agmlego/air-compressor-controller/Production/compressor schematic 3.jpg

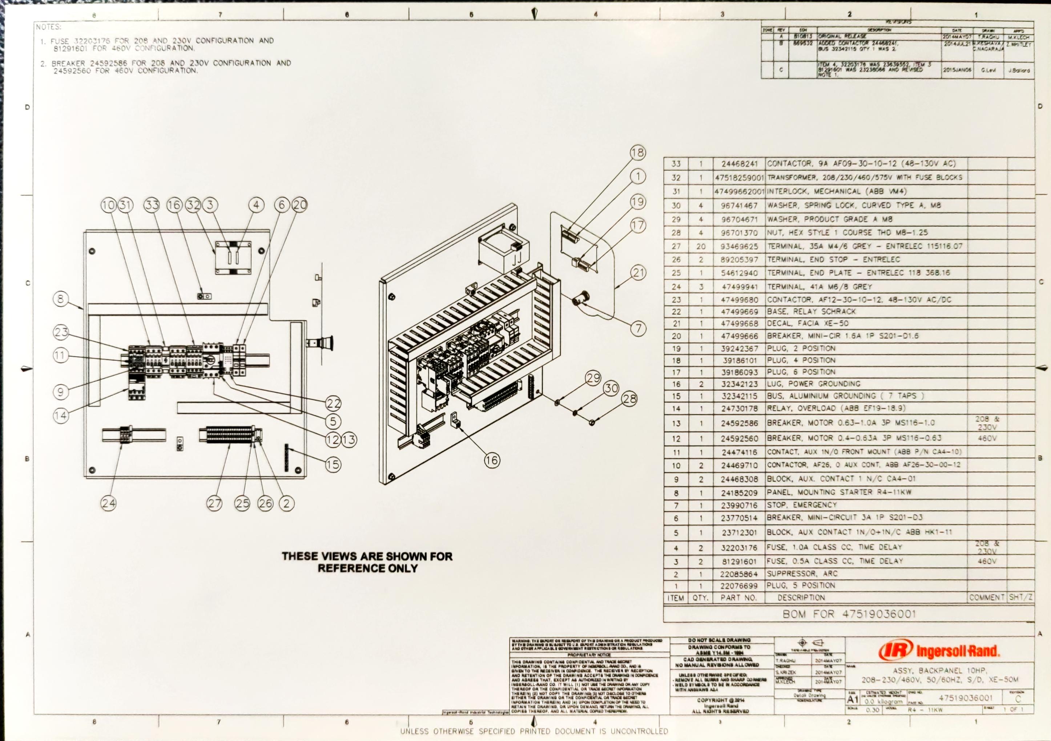
Production/compressor schematic 3.jpg
