agmlego/air-compressor-controller/Production/compressor schematic 1.jpg

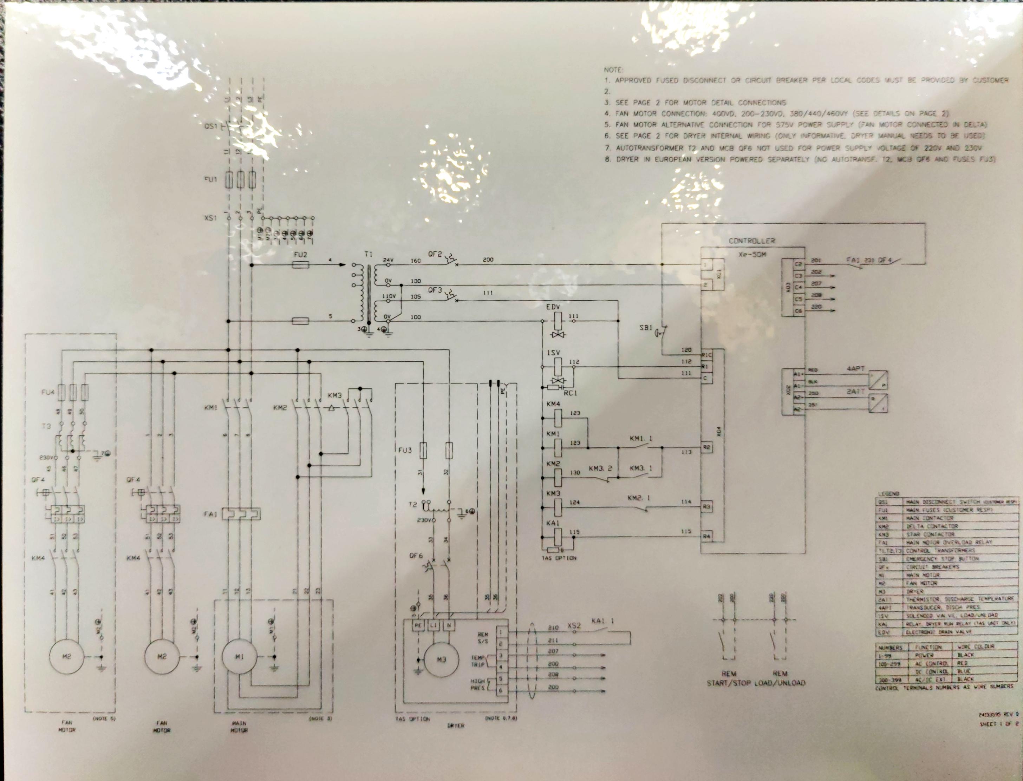
Production/compressor schematic 1.jpg
