agmlego/air-compressor-controller/Hardware/pins.xlsx

Conn ID | Connector | Pin | Signal | Terminal | PCB | Terminal | Y
J9 | Compressor controller | 8 | 0V |  | X
J9 | Compressor controller | 10 | BUS_DIR |  | X | Row Labels | Count of Signal | Terminals
J9 | Compressor controller | 6 | BUS_RX |  | X | 0V | 9 | 5
J9 | Compressor controller | 4 | BUS_TX |  | X | 24V | 5 | 3
J9 | Compressor controller | 2 | BUS_VCC |  | X | GND | 4 | 2
J1 | Power input | 2 | 0V | Y | Y | 5V | 4 | 2
J1 | Power input | 1 | 24V | Y | Y | L1 | 2 | 1
??? | 5V output | 1 | 5V | Y | Y | L2 | 2 | 1
A-PSI1 | A-side pressure sensor | 2 | A-PSI | Y | Y | RED | 1 | 1
B-PSI1 | B-side pressure sensor | 2 | B-PSI | Y | Y | OUT3 | 1 | 1
J8 | Compressor status | 2 | COMP-STATUS |  | Y | AMBER | 1 | 1
MAIN-PSI1 | Main pressure sensor | 2 | MAIN-PSI | Y | Y | A-PSI | 1 | 1
J9 | Compressor controller | 7 | OFF_BTN- |  | Y | OUT4 | 1 | 1
J9 | Compressor controller | 5 | OFF_BTN+ |  | Y | MAIN-PSI | 1 | 1
J9 | Compressor controller | 3 | ON_BTN- |  | Y | B-PSI | 1 | 1
J9 | Compressor controller | 1 | ON_BTN+ |  | Y | OUT1 | 1 | 1
A-SIDE1 | A-side valve | 2 | OUT1 | Y | Y | OUT2 | 1 | 1
A-SIDE1 | A-side valve | 4 | OUT2 | Y | Y | GREEN | 1 | 1
B-SIDE1 | B-side valve | 2 | OUT3 | Y | Y | Grand Total | 36
B-SIDE1 | B-side valve | 4 | OUT4 | Y | Y
STACKLIGHT1 | Stacklight | 4 | STACK_AMBER | Y | Y
STACKLIGHT1 | Stacklight | 5 | STACK_GREEN | Y | Y
STACKLIGHT1 | Stacklight | 3 | STACK_RED | Y | Y
??? | 5V output | 2 | 0V | Y
A-PSI1 | A-side pressure sensor | 3 | 0V | Y
A-SIDE1 | A-side valve | 3 | 0V | Y
B-PSI1 | B-side pressure sensor | 3 | 0V | Y
B-SIDE1 | B-side valve | 3 | 0V | Y
MAIN-PSI1 | Main pressure sensor | 3 | 0V | Y
PSU | Power supply | 2 | 0V | Y
STACKLIGHT1 | Stacklight | 6 | 0V | Y
A-SIDE1 | A-side valve | 1 | 24V | Y
B-SIDE1 | B-side valve | 1 | 24V | Y
PSU | Power supply | 1 | 24V | Y
STACKLIGHT1 | Stacklight | 1 | 24V | Y
J8 | Compressor status | 1 | 3V3
A-PSI1 | A-side pressure sensor | 1 | 5V | Y
B-PSI1 | B-side pressure sensor | 1 | 5V | Y
MAIN-PSI1 | Main pressure sensor | 1 | 5V | Y
MAINS | A/C supply | 1 | GND | Y
A-SIDE1 | A-side valve | 5 | GND | Y
B-SIDE1 | B-side valve | 5 | GND | Y
PSU | Power supply | 3 | GND | Y
MAINS | A/C supply | 2 | L1 | Y
PSU | Power supply | 4 | L1 | Y
MAINS | A/C supply | 3 | L2 | Y
PSU | Power supply | 5 | L2 | Y
J9 | Compressor controller | 9 | N/C
STACKLIGHT1 | Stacklight | 2 | N/C
