agmlego/air-compressor-controller/Production/compressor schematic 2.jpg

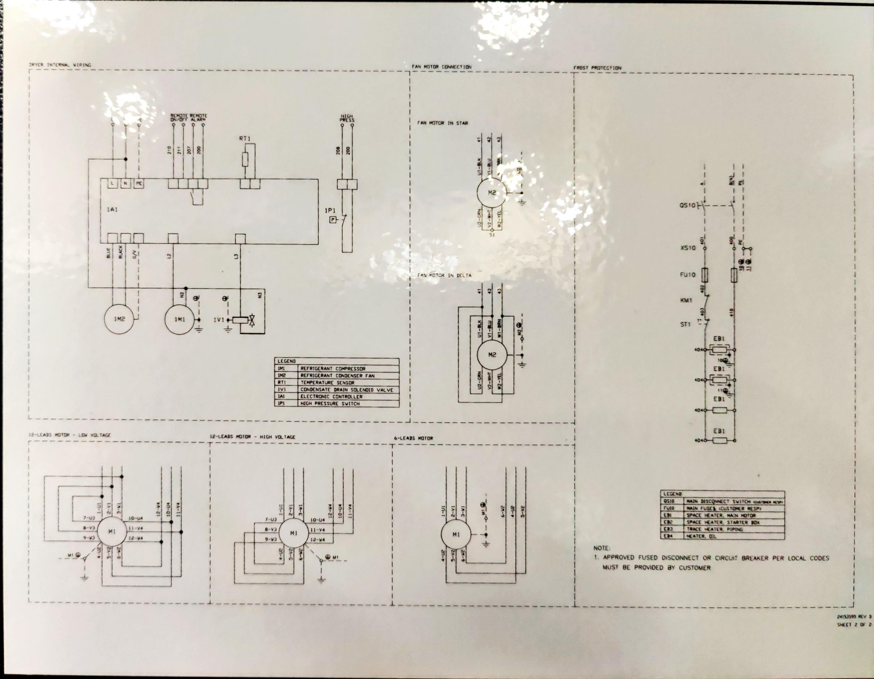
Production/compressor schematic 2.jpg
