agmlego/air-compressor-controller/Production/air-compressor-controller.xlsx

Id | Designator | Package | Designation | Supplier | Part Number | Source
12 | C10 | C_0603_1608Metric | 0.1µF | Digikey | 1276-1935-1-ND | Bag
12 | C6 | C_0603_1608Metric | 0.1µF | Digikey | 1276-1935-1-ND | Bag
12 | C7 | C_0603_1608Metric | 0.1µF | Digikey | 1276-1935-1-ND | Bag
12 | C8 | C_0603_1608Metric | 0.1µF | Digikey | 1276-1935-1-ND | Bag
12 | C9 | C_0603_1608Metric | 0.1µF | Digikey | 1276-1935-1-ND | Bag
32 | R10 | R_0603_1608Metric | 1K | Digikey | 1292-WR06X1001FTLCT-ND | Bag
32 | R11 | R_0603_1608Metric | 1K | Digikey | 1292-WR06X1001FTLCT-ND | Bag
32 | R12 | R_0603_1608Metric | 1K | Digikey | 1292-WR06X1001FTLCT-ND | Bag
32 | R30 | R_0603_1608Metric | 1K | Digikey | 1292-WR06X1001FTLCT-ND | Bag
32 | R31 | R_0603_1608Metric | 1K | Digikey | 1292-WR06X1001FTLCT-ND | Bag
6 | R13 | R_0603_1608Metric | 10K | Digikey | 1292-WR06X103JTLCT-ND | Bag
6 | R14 | R_0603_1608Metric | 10K | Digikey | 1292-WR06X103JTLCT-ND | Bag
6 | R15 | R_0603_1608Metric | 10K | Digikey | 1292-WR06X103JTLCT-ND | Bag
6 | R19 | R_0603_1608Metric | 10K | Digikey | 1292-WR06X103JTLCT-ND | Bag
6 | R20 | R_0603_1608Metric | 10K | Digikey | 1292-WR06X103JTLCT-ND | Bag
6 | R21 | R_0603_1608Metric | 10K | Digikey | 1292-WR06X103JTLCT-ND | Bag
6 | R33 | R_0603_1608Metric | 10K | Digikey | 1292-WR06X103JTLCT-ND | Bag
6 | R34 | R_0603_1608Metric | 10K | Digikey | 1292-WR06X103JTLCT-ND | Bag
6 | R5 | R_0603_1608Metric | 10K | Digikey | 1292-WR06X103JTLCT-ND | Bag
6 | R6 | R_0603_1608Metric | 10K | Digikey | 1292-WR06X103JTLCT-ND | Bag
6 | R8 | R_0603_1608Metric | 10K | Digikey | 1292-WR06X103JTLCT-ND | Bag
6 | R9 | R_0603_1608Metric | 10K | Digikey | 1292-WR06X103JTLCT-ND | Bag
34 | R39 | R_0603_1608Metric | 220 | Digikey | 1292-WR06X221JTLCT-ND | Bag
34 | R43 | R_0603_1608Metric | 220 | Digikey | 1292-WR06X221JTLCT-ND | Bag
34 | R45 | R_0603_1608Metric | 220 | Digikey | 1292-WR06X221JTLCT-ND | Bag
8 | R1 | R_0603_1608Metric | 2K2 | Digikey | 1292-WR06X222JTLCT-ND | Bag
8 | R2 | R_0603_1608Metric | 2K2 | Digikey | 1292-WR06X222JTLCT-ND | Bag
8 | R22 | R_0603_1608Metric | 2K2 | Digikey | 1292-WR06X222JTLCT-ND | Bag
8 | R23 | R_0603_1608Metric | 2K2 | Digikey | 1292-WR06X222JTLCT-ND | Bag
8 | R24 | R_0603_1608Metric | 2K2 | Digikey | 1292-WR06X222JTLCT-ND | Bag
8 | R25 | R_0603_1608Metric | 2K2 | Digikey | 1292-WR06X222JTLCT-ND | Bag
8 | R26 | R_0603_1608Metric | 2K2 | Digikey | 1292-WR06X222JTLCT-ND | Bag
8 | R27 | R_0603_1608Metric | 2K2 | Digikey | 1292-WR06X222JTLCT-ND | Bag
8 | R3 | R_0603_1608Metric | 2K2 | Digikey | 1292-WR06X222JTLCT-ND | Bag
8 | R32 | R_0603_1608Metric | 2K2 | Digikey | 1292-WR06X222JTLCT-ND | Bag
8 | R35 | R_0603_1608Metric | 2K2 | Digikey | 1292-WR06X222JTLCT-ND | Bag
8 | R36 | R_0603_1608Metric | 2K2 | Digikey | 1292-WR06X222JTLCT-ND | Bag
8 | R37 | R_0603_1608Metric | 2K2 | Digikey | 1292-WR06X222JTLCT-ND | Bag
8 | R40 | R_0603_1608Metric | 2K2 | Digikey | 1292-WR06X222JTLCT-ND | Bag
8 | R41 | R_0603_1608Metric | 2K2 | Digikey | 1292-WR06X222JTLCT-ND | Bag
30 | R4 | R_0603_1608Metric | 4.7K | Digikey | 1292-WR06X472JTLCT-ND | Bag
30 | R7 | R_0603_1608Metric | 4.7K | Digikey | 1292-WR06X472JTLCT-ND | Bag
2 | U6 | SMDIP-16_W9.53mm | LTV-847S | Digikey | 160-1371-5-ND | Bag
2 | U7 | SMDIP-16_W9.53mm | LTV-847S | Digikey | 160-1371-5-ND | Bag
1 | D1 | D_SOD-323F | PMEG3020EJ | Digikey | 1727-PMEG100T20ELXDXCT-ND | Bag
1 | D10 | D_SOD-323F | PMEG3020EJ | Digikey | 1727-PMEG100T20ELXDXCT-ND | Bag
1 | D11 | D_SOD-323F | PMEG3020EJ | Digikey | 1727-PMEG100T20ELXDXCT-ND | Bag
1 | D2 | D_SOD-323F | PMEG3020EJ | Digikey | 1727-PMEG100T20ELXDXCT-ND | Bag
1 | D3 | D_SOD-323F | PMEG3020EJ | Digikey | 1727-PMEG100T20ELXDXCT-ND | Bag
1 | D4 | D_SOD-323F | PMEG3020EJ | Digikey | 1727-PMEG100T20ELXDXCT-ND | Bag
1 | D5 | D_SOD-323F | PMEG3020EJ | Digikey | 1727-PMEG100T20ELXDXCT-ND | Bag
1 | D6 | D_SOD-323F | PMEG3020EJ | Digikey | 1727-PMEG100T20ELXDXCT-ND | Bag
1 | D7 | D_SOD-323F | PMEG3020EJ | Digikey | 1727-PMEG100T20ELXDXCT-ND | Bag
1 | D8 | D_SOD-323F | PMEG3020EJ | Digikey | 1727-PMEG100T20ELXDXCT-ND | Bag
1 | D9 | D_SOD-323F | PMEG3020EJ | Digikey | 1727-PMEG100T20ELXDXCT-ND | Bag
13 | U3 | ESP32-WROOM-32U | ESP32-WROOM-32U | Digikey | 1965-ESP32-WROOM-32UE-N16CT-ND | Bag
14 | K1 | sonoff relay | sonoff_relay | Digikey | 2449-J1001AS5VDC.20-ND | Bag
14 | K2 | sonoff relay | sonoff_relay | Digikey | 2449-J1001AS5VDC.20-ND | Bag
 | J1 Mate |  |  | Digikey | 277-14481-ND | Bag
9 | J1 | Wago_734-180_1x20_P3.50mm_Horizontal | Conn_01x20_Female | Digikey | 277-6923-ND | Bag
4 | 24V_LED1 | LED_0603_1608Metric | RED LED | Digikey | 3147-B19Y1USD-20C000113U1930CT-ND | Bag
4 | 3V3_LED1 | LED_0603_1608Metric | RED LED | Digikey | 3147-B19Y1USD-20C000113U1930CT-ND | Bag
4 | 5V_LED1 | LED_0603_1608Metric | RED LED | Digikey | 3147-B19Y1USD-20C000113U1930CT-ND | Bag
4 | A_BRKR_LED1 | LED_0603_1608Metric | RED LED | Digikey | 3147-B19Y1USD-20C000113U1930CT-ND | Bag
4 | A_CLOSE1 | LED_0603_1608Metric | RED LED | Digikey | 3147-B19Y1USD-20C000113U1930CT-ND | Bag
4 | A_ENABLE1 | LED_0603_1608Metric | RED LED | Digikey | 3147-B19Y1USD-20C000113U1930CT-ND | Bag
4 | B_BRKR_LED1 | LED_0603_1608Metric | RED LED | Digikey | 3147-B19Y1USD-20C000113U1930CT-ND | Bag
4 | B_CLOSE1 | LED_0603_1608Metric | RED LED | Digikey | 3147-B19Y1USD-20C000113U1930CT-ND | Bag
4 | B_ENABLE1 | LED_0603_1608Metric | RED LED | Digikey | 3147-B19Y1USD-20C000113U1930CT-ND | Bag
4 | OFF_BTN1 | LED_0603_1608Metric | RED LED | Digikey | 3147-B19Y1USD-20C000113U1930CT-ND | Bag
4 | RED_STACK1 | LED_0603_1608Metric | RED LED | Digikey | 3147-B19Y1USD-20C000113U1930CT-ND | Bag
21 | AMBER_STACK1 | LED_0603_1608Metric | AMBER LED | Digikey | 3147-B19Y1UY--20C000113U1930CT-ND | Bag
10 | A_OPEN1 | LED_0603_1608Metric | GREEN LED | Digikey | 3147-B19Y1UYG-20C000313U1930CT-ND | Bag
10 | B_OPEN1 | LED_0603_1608Metric | GREEN LED | Digikey | 3147-B19Y1UYG-20C000313U1930CT-ND | Bag
10 | COMP_DIR_LED1 | LED_0603_1608Metric | GREEN LED | Digikey | 3147-B19Y1UYG-20C000313U1930CT-ND | Bag
10 | COMP_LED1 | LED_0603_1608Metric | GREEN LED | Digikey | 3147-B19Y1UYG-20C000313U1930CT-ND | Bag
10 | COMP_RX_LED1 | LED_0603_1608Metric | GREEN LED | Digikey | 3147-B19Y1UYG-20C000313U1930CT-ND | Bag
10 | COMP_TX_LED1 | LED_0603_1608Metric | GREEN LED | Digikey | 3147-B19Y1UYG-20C000313U1930CT-ND | Bag
10 | GREEN_STACK1 | LED_0603_1608Metric | GREEN LED | Digikey | 3147-B19Y1UYG-20C000313U1930CT-ND | Bag
10 | ON_BTN1 | LED_0603_1608Metric | GREEN LED | Digikey | 3147-B19Y1UYG-20C000313U1930CT-ND | Bag
5 | C1 | CP_Elec_4x4.5 | 10µF | Digikey | 399-14794-1-ND | Bag
5 | C2 | CP_Elec_4x4.5 | 10µF | Digikey | 399-14794-1-ND | Bag
33 | C11 | C_0603_1608Metric | 4.7µF | Digikey | 490-7205-1-ND | Bag
33 | C12 | C_0603_1608Metric | 4.7µF | Digikey | 490-7205-1-ND | Bag
33 | C5 | C_0603_1608Metric | 4.7µF | Digikey | 490-7205-1-ND | Bag
19 | C3 | CP_Elec_4x4.5 | 22µF | Digikey | 493-14929-1-ND | Bag
23 | U1 | SOT-223-3_TabPin2 | LD1117S33TR_SOT223 | Digikey | 497-1228-1-ND | Bag
29 | C4 | C_0603_1608Metric | 1nF | Digikey | 732-8001-1-ND | Bag
28 | Q1 | SOT-23 | AO3400A | Digikey | 785-1004-1-ND | Bag
28 | Q2 | SOT-23 | AO3400A | Digikey | 785-1004-1-ND | Bag
28 | Q3 | SOT-23 | AO3400A | Digikey | 785-1004-1-ND | Bag
28 | Q4 | SOT-23 | AO3400A | Digikey | 785-1004-1-ND | Bag
28 | Q5 | SOT-23 | AO3400A | Digikey | 785-1004-1-ND | Bag
24 | R28 | R_1206_3216Metric | 0.5 | Digikey | CSR1206FTR500CT-ND | Bag
24 | R29 | R_1206_3216Metric | 0.5 | Digikey | CSR1206FTR500CT-ND | Bag
35 | U4 | SOIC-28W_7.5x17.9mm_P1.27mm | MCP23017_SO | Digikey | MCP23017-E/SO-ND | Bag
31 | R38 | R_0603_1608Metric | 1K2 | Digikey | RMCF0603JT1K20CT-ND | Bag
31 | R42 | R_0603_1608Metric | 1K2 | Digikey | RMCF0603JT1K20CT-ND | Bag
31 | R44 | R_0603_1608Metric | 1K2 | Digikey | RMCF0603JT1K20CT-ND | Bag
7 | R16 | R_0603_1608Metric | 20K | Digikey | RMCF0603JT20K0CT-ND | Bag
7 | R17 | R_0603_1608Metric | 20K | Digikey | RMCF0603JT20K0CT-ND | Bag
7 | R18 | R_0603_1608Metric | 20K | Digikey | RMCF0603JT20K0CT-ND | Bag
15 | H1 | MountingHole_3.2mm_M3_Pad | MountingHole |  |  | NoPop
15 | H2 | MountingHole_3.2mm_M3_Pad | MountingHole |  |  | NoPop
26 | J10 | PinHeader_1x04_P2.54mm_Vertical_SMD_Pin1Left | Conn_01x04 |  |  | i3Detroit
16 | J2 | PinHeader_2x03_P2.54mm_Vertical_SMD | Conn_02x03_Odd_Even |  |  | i3Detroit
3 | J3 | PinHeader_1x03_P2.54mm_Vertical_SMD_Pin1Left | Conn_01x03 |  |  | i3Detroit
17 | J4 | Tag-Connect_TC2050-IDC-NL_2x05_P1.27mm_Vertical | Conn_02x05_Odd_Even |  |  | NoPop
22 | J5 | Tag-Connect_TC2030-IDC-NL_2x03_P1.27mm_Vertical | Conn_02x03_Odd_Even |  |  | NoPop
3 | J6 | PinHeader_1x03_P2.54mm_Vertical_SMD_Pin1Left | Conn_01x03 |  |  | i3Detroit
20 | J8 | Molex_KK-254_AE-6410-05A_1x05_P2.54mm_Vertical | Conn_01x05 |  |  | i3Detroit
27 | SW1 | SW_Tactile_SPST_Angled_PTS645Vx39-2LFS | SW_Push |  |  | Bag
18 | U2 | Converter_DCDC_RECOM_R-78E-0.5_THT | R-78E5.0-0.5 |  |  | Bag
25 | U5 | TO-220-15_P2.54x2.54mm_StaggerOdd_Lead4.58mm_Vertical | L298N |  |  | i3Detroit
