agmlego/air-compressor-controller/Hardware/air-compressor-controller.kicad_pcb

## KiCad design Hardware/air-compressor-controller.kicad_pcb (2023-01-03)

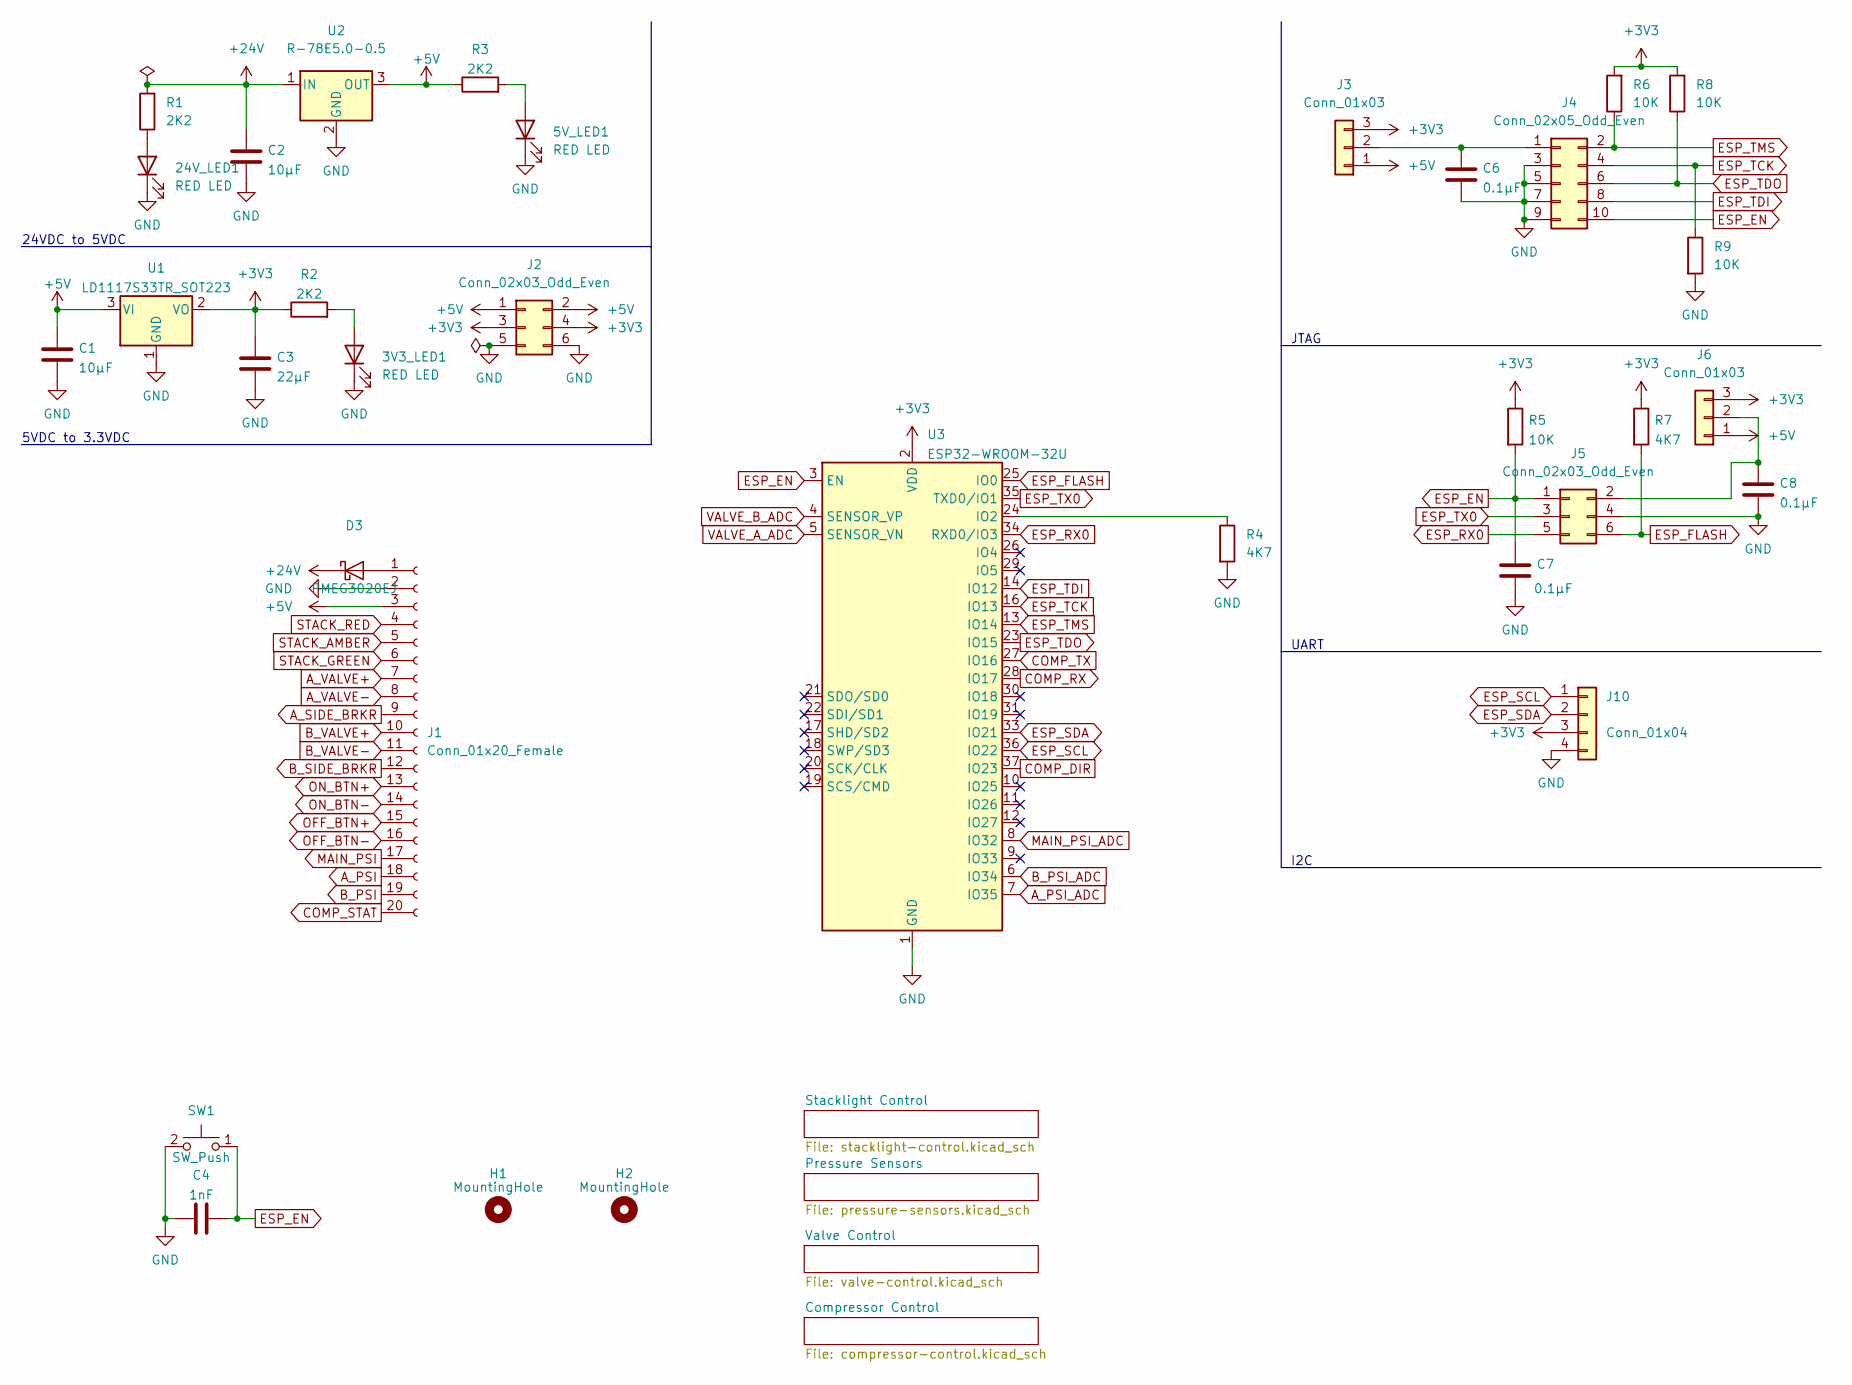
[picture p9: schematic air-compressor-controller.kicad_sch, ESPHome Air Compressor Controller Board]

Parts:
3V3_LED1, 5V_LED1, 24V_LED1: RED LED; LED_0603_1608Metric
C1, C2: 10µF; CP_Elec_4x4.5
C3: 22µF; CP_Elec_4x4.5
C4: 1nF; C_0603_1608Metric
C6, C7, C8: 0.1µF; C_0603_1608Metric
D3: PMEG3020EJ; D_SOD-323F
H1, H2: MountingHole; MountingHole_3.2mm_M3_Pad
J1: Conn_01x20_Female; Wago_734-180_1x20_P3.50mm_Horizontal
J2: Conn_02x03_Odd_Even; PinHeader_2x03_P2.54mm_Vertical_SMD
J3, J6: Conn_01x03; PinHeader_1x03_P2.54mm_Vertical_SMD_Pin1Left
J4: Conn_02x05_Odd_Even; Tag-Connect_TC2050-IDC-NL_2x05_P1.27mm_Vertical
J5: Conn_02x03_Odd_Even; Tag-Connect_TC2030-IDC-NL_2x03_P1.27mm_Vertical
J10: Conn_01x04; PinHeader_1x04_P2.54mm_Vertical_SMD_Pin1Left
R1, R2, R3: 2K2; R_0603_1608Metric
R4, R7: 4K7; R_0603_1608Metric
R5, R6, R8, R9: 10K; R_0603_1608Metric
SW1: SW_Push; SW_Tactile_SPST_Angled_PTS645Vx39-2LFS
U1: LD1117S33TR_SOT223; SOT-223-3_TabPin2
U2: R-78E5.0-0.5; Converter_DCDC_RECOM_R-78E-0.5_THT
U3: ESP32-WROOM-32U

Connections:
+3V3: C3.1, J2.3, J2.4, J3.3, J6.3, J10.3, R2.1, R5.1, R6.2, R7.1, R8.2, U1.2 (VO), U3.2 (VDD); also elsewhere on the board
+5V: C1.1, J1.3, J2.1, J2.2, J3.1, J6.1, R3.1, U1.3 (VI), U2.3 (OUT); also elsewhere on the board
+24V: C2.1, D3.1 (K), R1.2, U2.1 (IN); also elsewhere on the board
A_PSI: J1.18; also elsewhere on the board
A_PSI_ADC: U3.7 (IO35); also elsewhere on the board
A_SIDE_BRKR: J1.9; also elsewhere on the board
A_VALVE+: J1.7; also elsewhere on the board
A_VALVE-: J1.8; also elsewhere on the board
B_PSI: J1.19; also elsewhere on the board
B_PSI_ADC: U3.6 (IO34); also elsewhere on the board
B_SIDE_BRKR: J1.12; also elsewhere on the board
B_VALVE+: J1.10; also elsewhere on the board
B_VALVE-: J1.11; also elsewhere on the board
COMP_DIR: U3.37 (IO23); also elsewhere on the board
COMP_RX: U3.28 (IO17); also elsewhere on the board
COMP_STAT: J1.20; also elsewhere on the board
COMP_TX: U3.27 (IO16); also elsewhere on the board
ESP_EN: C4.2, C7.1, J4.10, J5.1, R5.2, SW1.1, U3.3 (EN); also elsewhere on the board
ESP_FLASH: J5.6, R7.2, U3.25 (IO0)
ESP_RX0: J5.5, U3.34 (RXD0/IO3)
ESP_SCL: J10.1, U3.36 (IO22); also elsewhere on the board
ESP_SDA: J10.2, U3.33 (IO21); also elsewhere on the board
ESP_TCK: J4.4, R9.1, U3.16 (IO13)
ESP_TDI: J4.8, U3.14 (IO12)
ESP_TDO: J4.6, R8.1, U3.23 (IO15)
ESP_TMS: J4.2, R6.1, U3.13 (IO14)
ESP_TX0: J5.3, U3.35 (TXD0/IO1)
GND: 3V3_LED1.1 (K), 5V_LED1.1 (K), 24V_LED1.1 (K), C1.2, C2.2, C3.2, C4.1, C6.2, C7.2, C8.2, J1.2, J2.5, J2.6, J4.3, J4.5, J4.7, J4.9, J5.4, J10.4, R4.2, R9.2, SW1.2, U1.1 (GND), U2.2 (GND), U3.1 (GND), U3.15 (GND), U3.38 (GND), U3.39 (GND); also elsewhere on the board
MAIN_PSI: J1.17; also elsewhere on the board
MAIN_PSI_ADC: U3.8 (IO32); also elsewhere on the board
unnamed: 3V3_LED1.2 (A), R2.2
unnamed: 5V_LED1.2 (A), R3.2
unnamed: 24V_LED1.2 (A), R1.1
unnamed: C6.1, J3.2, J4.1
unnamed: C8.1, J5.2, J6.2
unnamed: D3.2 (A), J1.1
unnamed: R4.1, U3.24 (IO2)
OFF_BTN+: J1.15; also elsewhere on the board
OFF_BTN-: J1.16; also elsewhere on the board
ON_BTN+: J1.13; also elsewhere on the board
ON_BTN-: J1.14; also elsewhere on the board
STACK_AMBER: J1.5; also elsewhere on the board
STACK_GREEN: J1.6; also elsewhere on the board
STACK_RED: J1.4; also elsewhere on the board
VALVE_A_ADC: U3.5 (SENSOR_VN); also elsewhere on the board
VALVE_B_ADC: U3.4 (SENSOR_VP); also elsewhere on the board

Notes on the sheet:
JTAG
UART
I2C
24VDC to 5VDC
5VDC to 3.3VDC

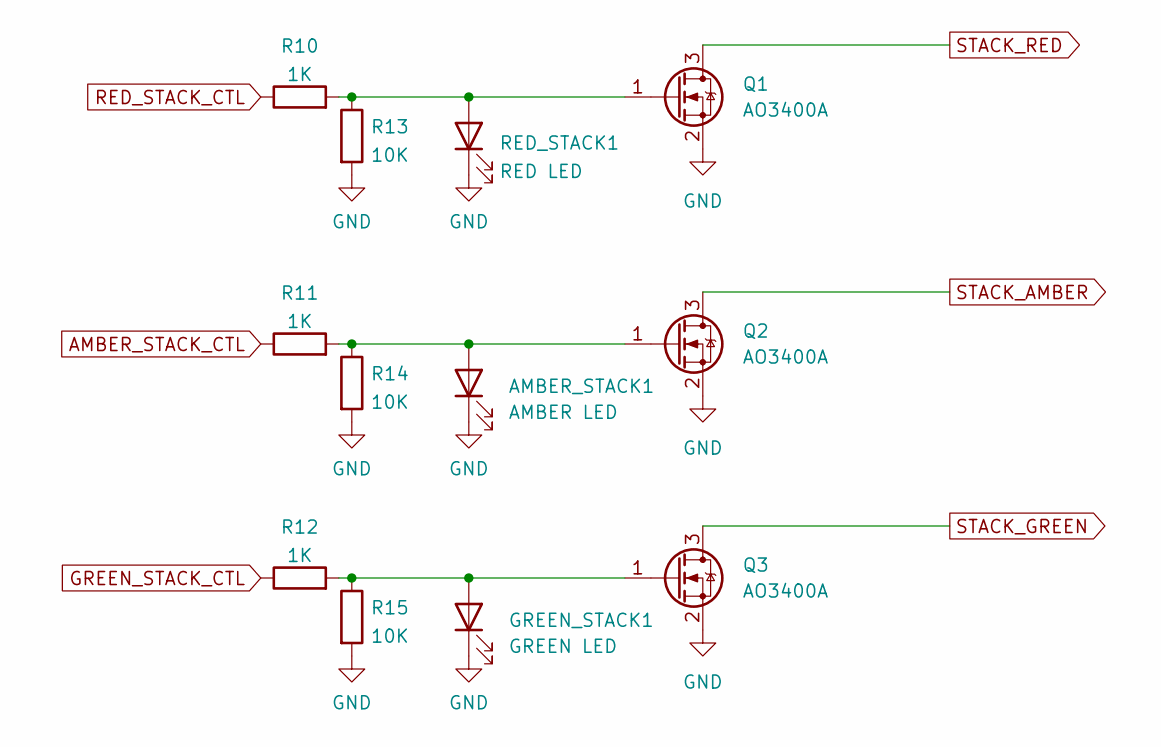
[picture p10: schematic stacklight-control.kicad_sch, Stacklight Control]

Parts:
AMBER_STACK1: AMBER LED; LED_0603_1608Metric
GREEN_STACK1: GREEN LED; LED_0603_1608Metric
Q1, Q2, Q3: AO3400A; SOT-23
R10, R11, R12: 1K; R_0603_1608Metric
R13, R14, R15: 10K; R_0603_1608Metric
RED_STACK1: RED LED; LED_0603_1608Metric

Connections:
AMBER_STACK_CTL: R11.1; also elsewhere on the board
GND: AMBER_STACK1.1 (K), GREEN_STACK1.1 (K), Q1.2 (S), Q2.2 (S), Q3.2 (S), R13.2, R14.2, R15.2, RED_STACK1.1 (K); also elsewhere on the board
GREEN_STACK_CTL: R12.1; also elsewhere on the board
unnamed: AMBER_STACK1.2 (A), Q2.1 (G), R11.2, R14.1
unnamed: GREEN_STACK1.2 (A), Q3.1 (G), R12.2, R15.1
unnamed: Q1.1 (G), R10.2, R13.1, RED_STACK1.2 (A)
RED_STACK_CTL: R10.1; also elsewhere on the board
STACK_AMBER: Q2.3 (D); also elsewhere on the board
STACK_GREEN: Q3.3 (D); also elsewhere on the board
STACK_RED: Q1.3 (D); also elsewhere on the board

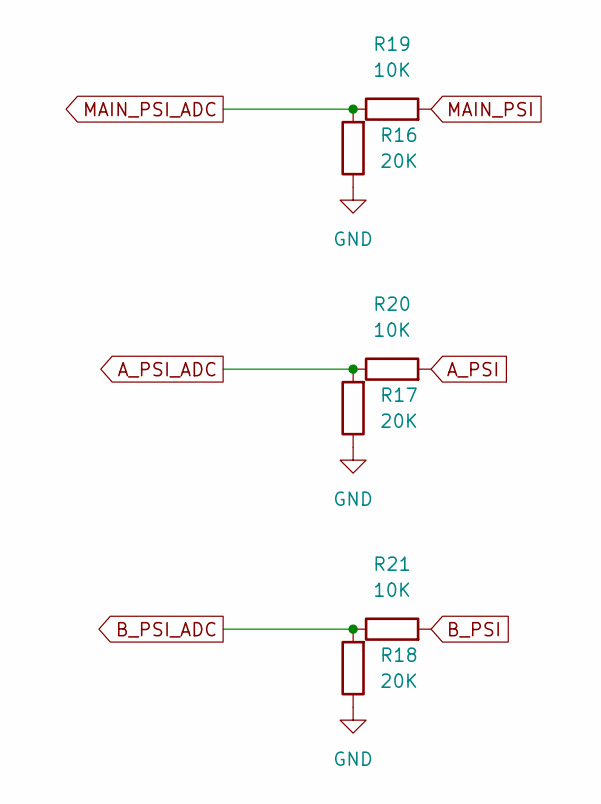
[picture p11: schematic pressure-sensors.kicad_sch, Pressure Sensors]

Parts:
R16, R17, R18: 20K; R_0603_1608Metric
R19, R20, R21: 10K; R_0603_1608Metric

Connections:
A_PSI: R20.2; also elsewhere on the board
A_PSI_ADC: R17.2, R20.1; also elsewhere on the board
B_PSI: R21.2; also elsewhere on the board
B_PSI_ADC: R18.2, R21.1; also elsewhere on the board
GND: R16.1, R17.1, R18.1; also elsewhere on the board
MAIN_PSI: R19.2; also elsewhere on the board
MAIN_PSI_ADC: R16.2, R19.1; also elsewhere on the board

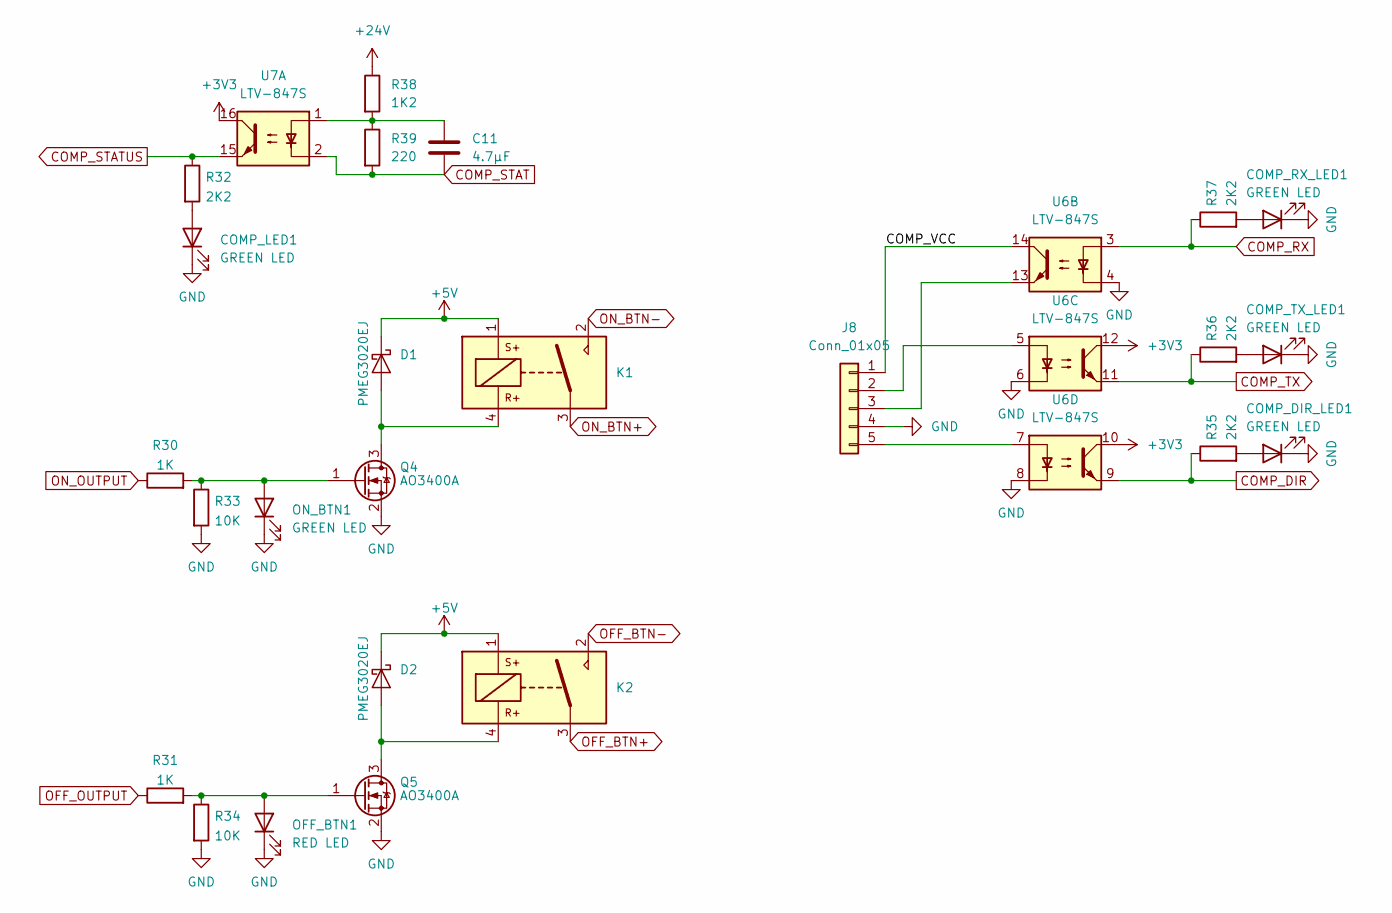
[picture p12: schematic compressor-control.kicad_sch, Compressor Control]

Parts:
C11: 4.7μF; C_0603_1608Metric
COMP_DIR_LED1: GREEN LED; LED_0603_1608Metric
COMP_LED1: GREEN LED; LED_0603_1608Metric
COMP_RX_LED1: GREEN LED; LED_0603_1608Metric
COMP_TX_LED1: GREEN LED; LED_0603_1608Metric
D1, D2: PMEG3020EJ; D_SOD-323F
J8: Conn_01x05; Molex_KK-254_AE-6410-05A_1x05_P2.54mm_Vertical
K1, K2: sonoff_relay; sonoff relay
OFF_BTN1: RED LED; LED_0603_1608Metric
ON_BTN1: GREEN LED; LED_0603_1608Metric
Q4, Q5: AO3400A; SOT-23
R30, R31: 1K; R_0603_1608Metric
R32, R35, R36, R37: 2K2; R_0603_1608Metric
R33, R34: 10K; R_0603_1608Metric
R38: 1K2; R_0603_1608Metric
R39: 220; R_0603_1608Metric
U6, U7: LTV-847S; SMDIP-16_W9.53mm

Connections:
+3V3: U6.10, U6.12, U7.16; also elsewhere on the board
+5V: D1.1 (K), D2.1 (K), K1.1, K2.1; also elsewhere on the board
+24V: R38.1; also elsewhere on the board
/Compressor Control/COMP_VCC: J8.1, U6.14
COMP_DIR: R35.1, U6.9; also elsewhere on the board
COMP_RX: R37.1, U6.3; also elsewhere on the board
COMP_STAT: C11.1, R39.2, U7.2; also elsewhere on the board
COMP_STATUS: R32.1, U7.15; also elsewhere on the board
COMP_TX: R36.1, U6.11; also elsewhere on the board
GND: COMP_DIR_LED1.1 (K), COMP_LED1.1 (K), COMP_RX_LED1.1 (K), COMP_TX_LED1.1 (K), J8.4, OFF_BTN1.1 (K), ON_BTN1.1 (K), Q4.2 (S), Q5.2 (S), R33.2, R34.2, U6.4, U6.6, U6.8; also elsewhere on the board
unnamed: C11.2, R38.2, R39.1, U7.1
unnamed: COMP_DIR_LED1.2 (A), R35.2
unnamed: COMP_LED1.2 (A), R32.2
unnamed: COMP_RX_LED1.2 (A), R37.2
unnamed: COMP_TX_LED1.2 (A), R36.2
unnamed: D1.2 (A), K1.4, Q4.3 (D)
unnamed: D2.2 (A), K2.4, Q5.3 (D)
unnamed: J8.2, U6.5
unnamed: J8.3, U6.13
unnamed: J8.5, U6.7
unnamed: OFF_BTN1.2 (A), Q5.1 (G), R31.2, R34.1
unnamed: ON_BTN1.2 (A), Q4.1 (G), R30.2, R33.1
OFF_BTN+: K2.3; also elsewhere on the board
OFF_BTN-: K2.2; also elsewhere on the board
OFF_OUTPUT: R31.1; also elsewhere on the board
ON_BTN+: K1.3; also elsewhere on the board
ON_BTN-: K1.2; also elsewhere on the board
ON_OUTPUT: R30.1; also elsewhere on the board

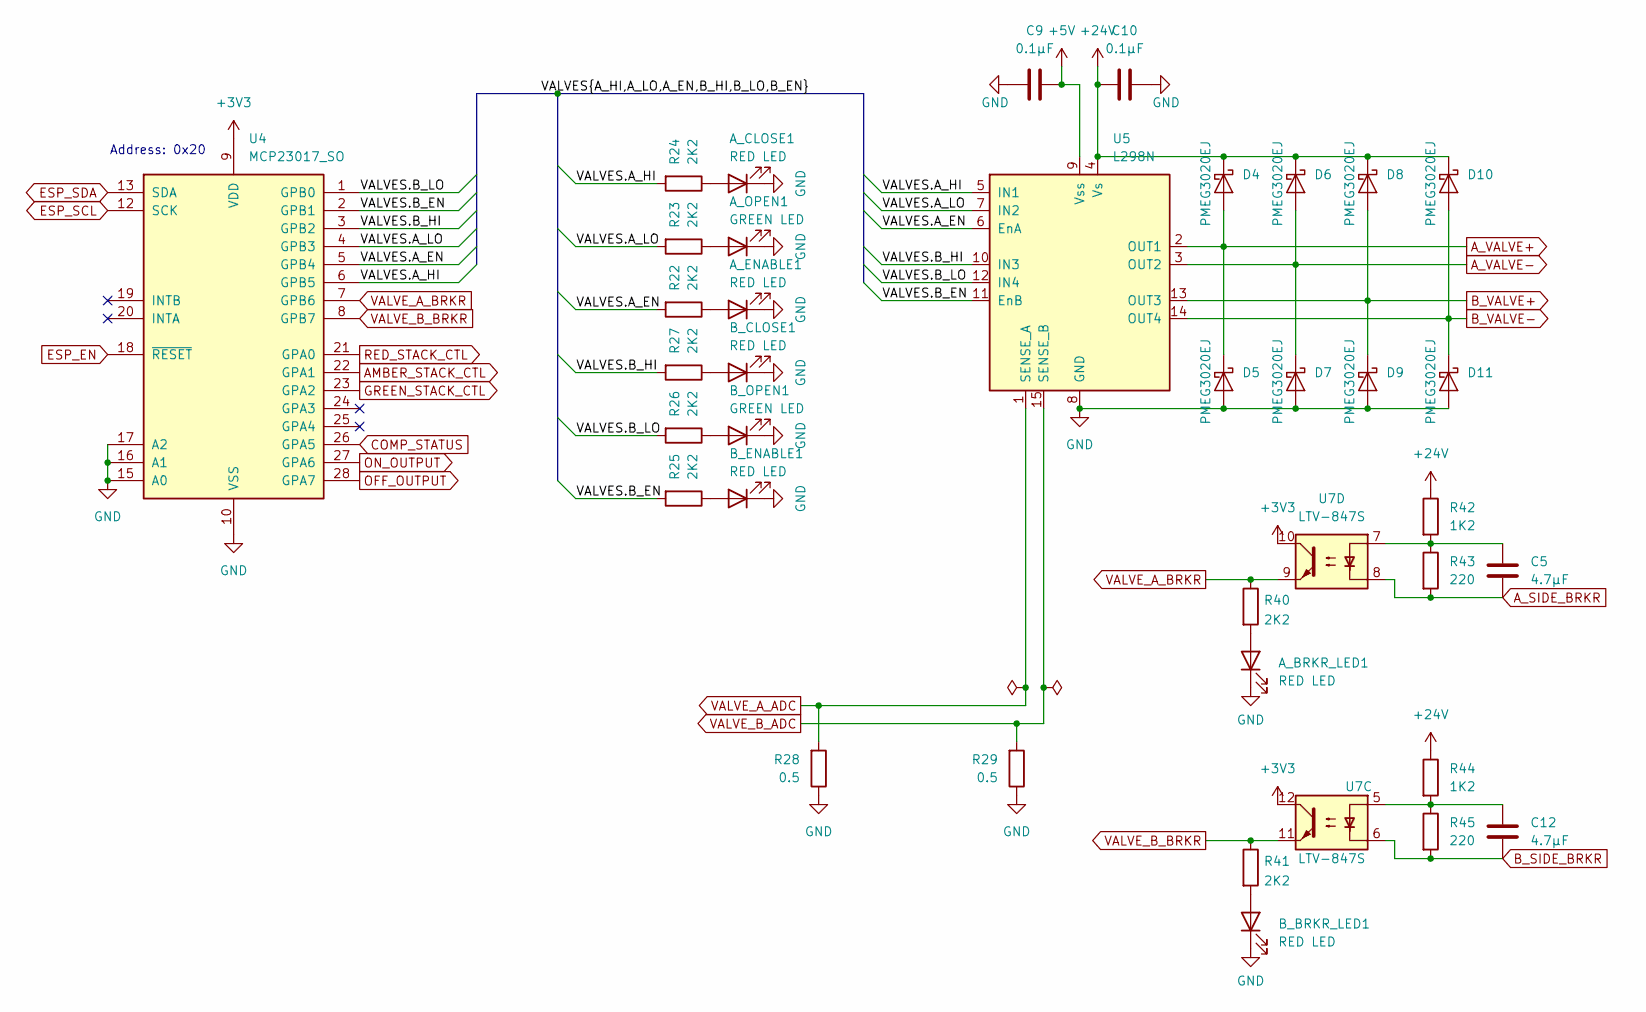
[picture p13: schematic valve-control.kicad_sch, Valve Control]

Parts:
A_BRKR_LED1: RED LED; LED_0603_1608Metric
A_CLOSE1: RED LED; LED_0603_1608Metric
A_ENABLE1: RED LED; LED_0603_1608Metric
A_OPEN1: GREEN LED; LED_0603_1608Metric
B_BRKR_LED1: RED LED; LED_0603_1608Metric
B_CLOSE1: RED LED; LED_0603_1608Metric
B_ENABLE1: RED LED; LED_0603_1608Metric
B_OPEN1: GREEN LED; LED_0603_1608Metric
C5, C12: 4.7μF; C_0603_1608Metric
C9, C10: 0.1µF; C_0603_1608Metric
D4, D5, D6, D7, D8, D9, D10, D11: PMEG3020EJ; D_SOD-323F
R22, R23, R24, R25, R26, R27, R40, R41: 2K2; R_0603_1608Metric
R28, R29: 0.5; R_1206_3216Metric
R42, R44: 1K2; R_0603_1608Metric
R43, R45: 220; R_0603_1608Metric
U4: MCP23017_SO; SOIC-28W_7.5x17.9mm_P1.27mm
U5: L298N; TO-220-15_P2.54x2.54mm_StaggerOdd_Lead4.58mm_Vertical
U7: LTV-847S; SMDIP-16_W9.53mm

Connections:
+3V3: U4.9 (VDD), U7.10, U7.12; also elsewhere on the board
+5V: C9.2, U5.9 (Vss); also elsewhere on the board
+24V: C10.1, D4.1 (K), D6.1 (K), D8.1 (K), D10.1 (K), R42.1, R44.1, U5.4 (Vs); also elsewhere on the board
/Valve Control/VALVES.A_EN: R22.2, U4.5 (GPB4), U5.6 (EnA)
/Valve Control/VALVES.A_HI: R24.2, U4.6 (GPB5), U5.5 (IN1)
/Valve Control/VALVES.A_LO: R23.2, U4.4 (GPB3), U5.7 (IN2)
/Valve Control/VALVES.B_EN: R25.2, U4.2 (GPB1), U5.11 (EnB)
/Valve Control/VALVES.B_HI: R27.2, U4.3 (GPB2), U5.10 (IN3)
/Valve Control/VALVES.B_LO: R26.2, U4.1 (GPB0), U5.12 (IN4)
AMBER_STACK_CTL: U4.22 (GPA1); also elsewhere on the board
A_SIDE_BRKR: C5.1, R43.2, U7.8; also elsewhere on the board
A_VALVE+: D4.2 (A), D5.1 (K), U5.2 (OUT1); also elsewhere on the board
A_VALVE-: D6.2 (A), D7.1 (K), U5.3 (OUT2); also elsewhere on the board
B_SIDE_BRKR: C12.1, R45.2, U7.6; also elsewhere on the board
B_VALVE+: D8.2 (A), D9.1 (K), U5.13 (OUT3); also elsewhere on the board
B_VALVE-: D10.2 (A), D11.1 (K), U5.14 (OUT4); also elsewhere on the board
COMP_STATUS: U4.26 (GPA5); also elsewhere on the board
ESP_EN: U4.18 (~RESET); also elsewhere on the board
ESP_SCL: U4.12 (SCK); also elsewhere on the board
ESP_SDA: U4.13 (SDA); also elsewhere on the board
GND: A_BRKR_LED1.1 (K), A_CLOSE1.1 (K), A_ENABLE1.1 (K), A_OPEN1.1 (K), B_BRKR_LED1.1 (K), B_CLOSE1.1 (K), B_ENABLE1.1 (K), B_OPEN1.1 (K), C9.1, C10.2, D5.2 (A), D7.2 (A), D9.2 (A), D11.2 (A), R28.1, R29.1, U4.10 (VSS), U4.15 (A0), U4.16 (A1), U4.17 (A2), U5.8 (GND); also elsewhere on the board
GREEN_STACK_CTL: U4.23 (GPA2); also elsewhere on the board
unnamed: A_BRKR_LED1.2 (A), R40.2
unnamed: A_CLOSE1.2 (A), R24.1
unnamed: A_ENABLE1.2 (A), R22.1
unnamed: A_OPEN1.2 (A), R23.1
unnamed: B_BRKR_LED1.2 (A), R41.2
unnamed: B_CLOSE1.2 (A), R27.1
unnamed: B_ENABLE1.2 (A), R25.1
unnamed: B_OPEN1.2 (A), R26.1
unnamed: C5.2, R42.2, R43.1, U7.7
unnamed: C12.2, R44.2, R45.1, U7.5
OFF_OUTPUT: U4.28 (GPA7); also elsewhere on the board
ON_OUTPUT: U4.27 (GPA6); also elsewhere on the board
RED_STACK_CTL: U4.21 (GPA0); also elsewhere on the board
VALVE_A_ADC: R28.2, U5.1 (SENSE_A); also elsewhere on the board
VALVE_A_BRKR: R40.1, U4.7 (GPB6), U7.9
VALVE_B_ADC: R29.2, U5.15 (SENSE_B); also elsewhere on the board
VALVE_B_BRKR: R41.1, U4.8 (GPB7), U7.11

Notes on the sheet:
Address: 0x20

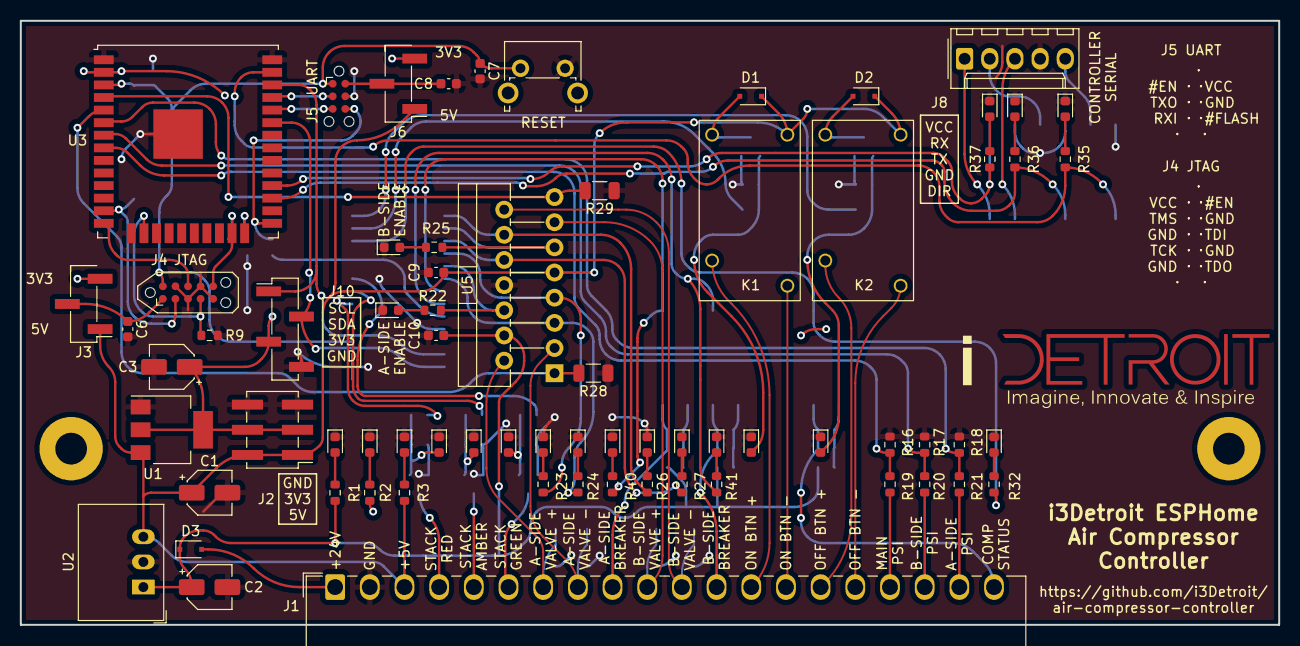
[picture p14: board air-compressor-controller.kicad_pcb from above]

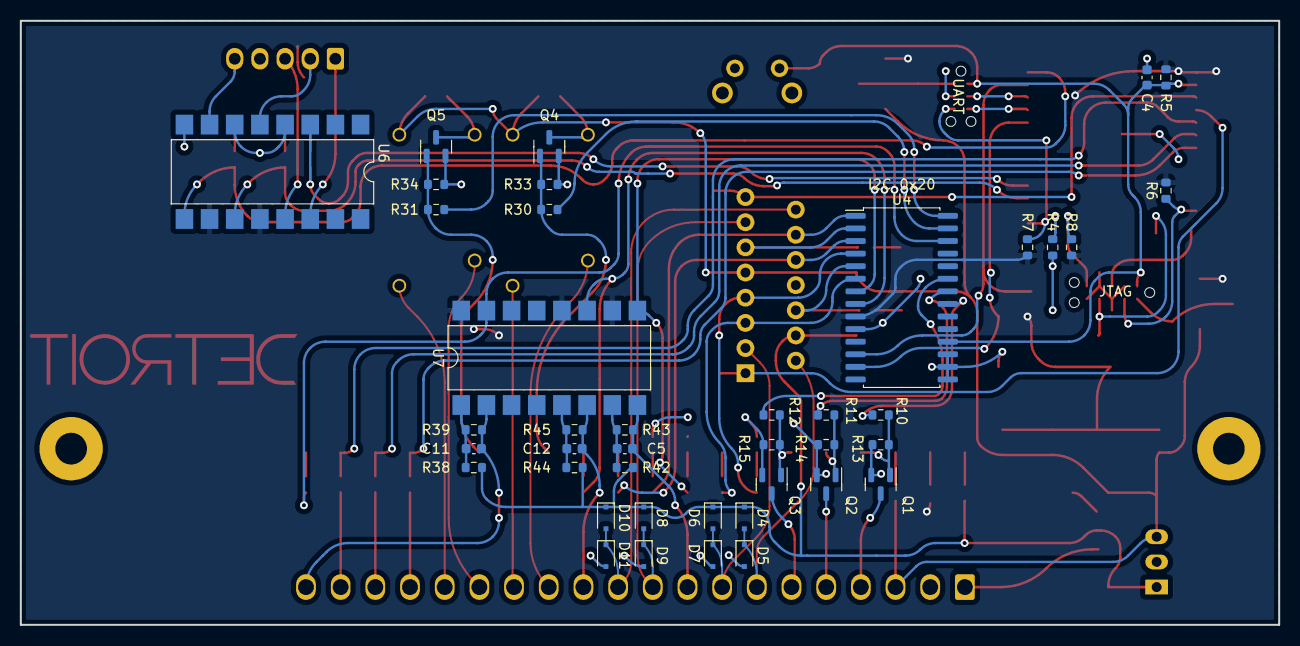
[picture p15: board air-compressor-controller.kicad_pcb from below]

Board: 2 copper layers, 127.0 x 61.0 mm, 113 parts (41 on the bottom side), 86 nets.
