agmlego/air-compressor-controller/(commit log)

2022-10-17 Initial schematic
    [air-compressor-controller.kicad_pcb, air-compressor-controller.kicad_sch, compressor-control.kicad_sch, pressure-sensors.kicad_sch, stacklight-control.kicad_sch, valve-control.kicad_sch]
2022-10-19 Move to organization structure
    [air-compressor-controller.kicad_pcb, air-compressor-controller.kicad_sch, compressor-control.kicad_sch, pressure-sensors.kicad_sch, stacklight-control.kicad_sch, valve-control.kicad_sch]
2022-10-19 Added I2C block
    [air-compressor-controller.kicad_sch, compressor-control.kicad_sch]
2022-10-19 Corrected relay footprints
    [compressor-control.kicad_sch]
2022-10-19 Removed Zener diodes on ADC channels
    [valve-control.kicad_sch]
2022-10-19 Beginning of PCB layout
    [air-compressor-controller.kicad_pcb, air-compressor-controller.kicad_sch]
2022-11-07 Added breakout to terminal blocks
    [pins.xlsx]
2022-11-07 Changed connectors to a common header, much routing done.
    [air-compressor-controller.kicad_pcb, air-compressor-controller.kicad_sch, compressor-control.kicad_sch, pressure-sensors.kicad_sch, stacklight-control.kicad_sch, valve-control.kicad_sch]
2022-11-17 Finalised routing, silkscreen yet to do
    [air-compressor-controller.kicad_pcb, air-compressor-controller.kicad_sch, compressor-control.kicad_sch]
2022-11-17 Silk and routing complete.
    [air-compressor-controller.kicad_pcb, air-compressor-controller.kicad_sch, compressor-control.kicad_sch]
2022-11-18 Added flyback diodes to L298N outputs
    [air-compressor-controller.csv, air-compressor-controller.kicad_pcb, air-compressor-controller.kicad_sch, air-compressor-controller.xlsx, compressor-control.kicad_sch, valve-control.kicad_sch]
2023-01-03 Actually routed stacklight control pins...
    [air-compressor-controller.kicad_pcb, air-compressor-controller.xlsx, valve-control.kicad_sch]
2023-01-04 Added interactive BOM
